ionutandrone01/VOLTAGE-AMPLIFIER/ANDRONE_Ionut_VOLTAGE AMPLIFIER/Layout/Layout.jpg

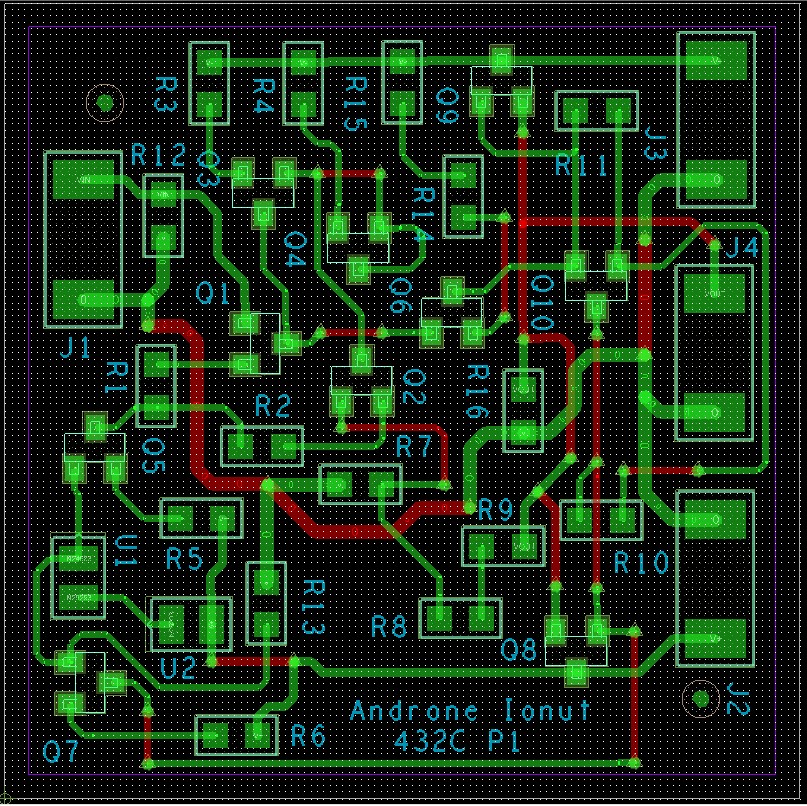
ANDRONE_Ionut_VOLTAGE AMPLIFIER/Layout/Layout.jpg
