ionutandrone01/VOLTAGE-AMPLIFIER/ANDRONE_Ionut_VOLTAGE AMPLIFIER/Project docs/ANDRONE_Ionut_AAF.pdf

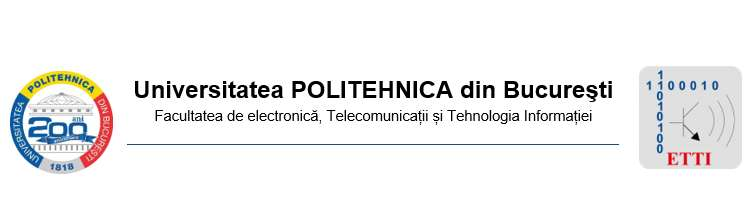
[picture p2: figure]

# PROIECT 1

# DISPOZITIVE SI CIRCUITE ELECTRONICE

# AMPLIFICATOR DE TENSIUNE

PROFESORI COORDONATORI: Ș. I. Dr. Ing. Miron Jean Cristea

Dr. Ing. Niculina Drăghici

## STUDENT: ANDRONE IONUȚ

## GRUPA 432C

## CUPRINS

1. Tema proiectului | pag. 3
2. Schema bloc | pag. 3
3. Schema electrica | pag. 4
4. Detalii de proiectare | pag. 4
4.1. Etajul diferential | pag. 6
4.2. Etajul emitor comun degenerat | pag. 6
4.3. Etajul de iesire in clasa AB | pag. 6
4.4. Sursa de curent | pag. 7
4.5. Oglinda de curent | pag. 7
5. Functionalitatea circuitului | pag. 8
6. Punctul static de functionare | pag. 9
7. Amplificarea in bucla inchisa | pag. 13
8. Amplificarea in bucla deschisa | pag. 14
9. Impedanta de intrare | pag. 15
10. Analiza domeniului temperaturilor de functionare | pag. 15
11. Bill of materials (BOM) | pag. 16
12.Bibliografie | pag. 16

1. TEMA PROIECTULUI (N=3):

Sa se proiecteze și realizeze un amplificator de tensiune avand urmatoarele caracteristici:

¨ Amplificarea de tensiune Av = 3 + N/2 = 3 + 1.5 = 4.5

¨ Tensiunea de intrare sinusoidala cu amplitudinea de 100mVv-v și f=1KHz;

¨ Impedanta de intrare 100kΩ;

¨ Rezistenta de sarcina 1Ω;

¨ Domeniul temperaturilor de functionare: 0

0C - 70⁰C (verificabil prin testare în temperatura);

¨ Amplificarea in tensiune minima (în buclă deschisa) a amplificatorului: minim 200;

¨ Semnalizarea prezenței tensiunilor de intrare/iesire cu dioda de tip LED.

### 2. SCHEMA BLOC A CIRCUITULUI

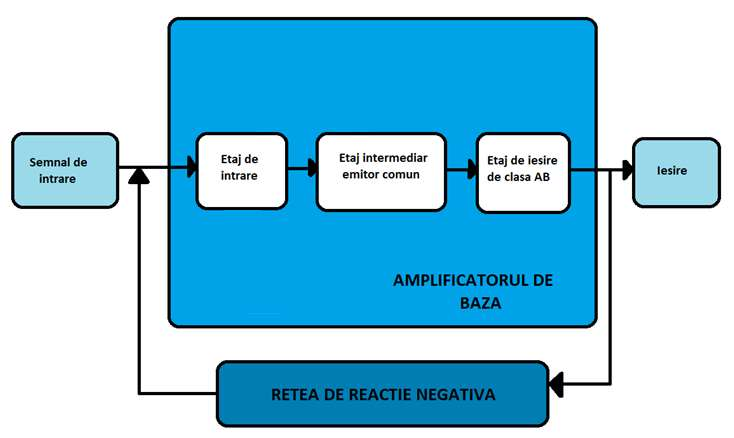
[picture p3: figure]

### 3. Schema electrica (in bucla inchisa)

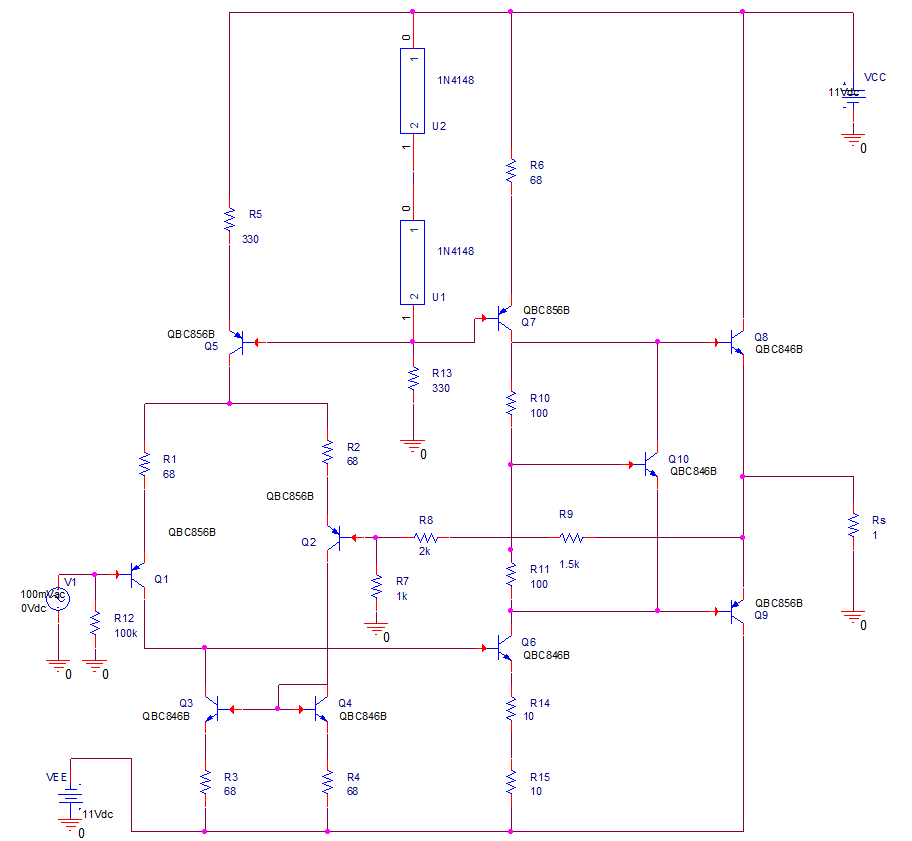
[picture p4: figure]

### 4. Detalii de proiectare

Circuitul este un amplificator de joasa frecventa cu reactie serie-paralel. Acesta este alcatuit din amplificatorul de baza si reteaua de reactie negativa. Amplificatorul de baza este la randul sau alcatuit din urmatoarele blocuri:
- Etajul de intrare: Etajul diferential
- Etajul intermediar: Etajul emitor comun degenerat
- Etajul de iesire: Etajul de clasa AB

Amplificatorul de baza prezinta totodata si alte 2 blocuri esentiale pentru functionarea circuitului:

- Sursa de curent
- Oglinda de curent

In figura urmatoare se evidentiaza fiecare bloc:

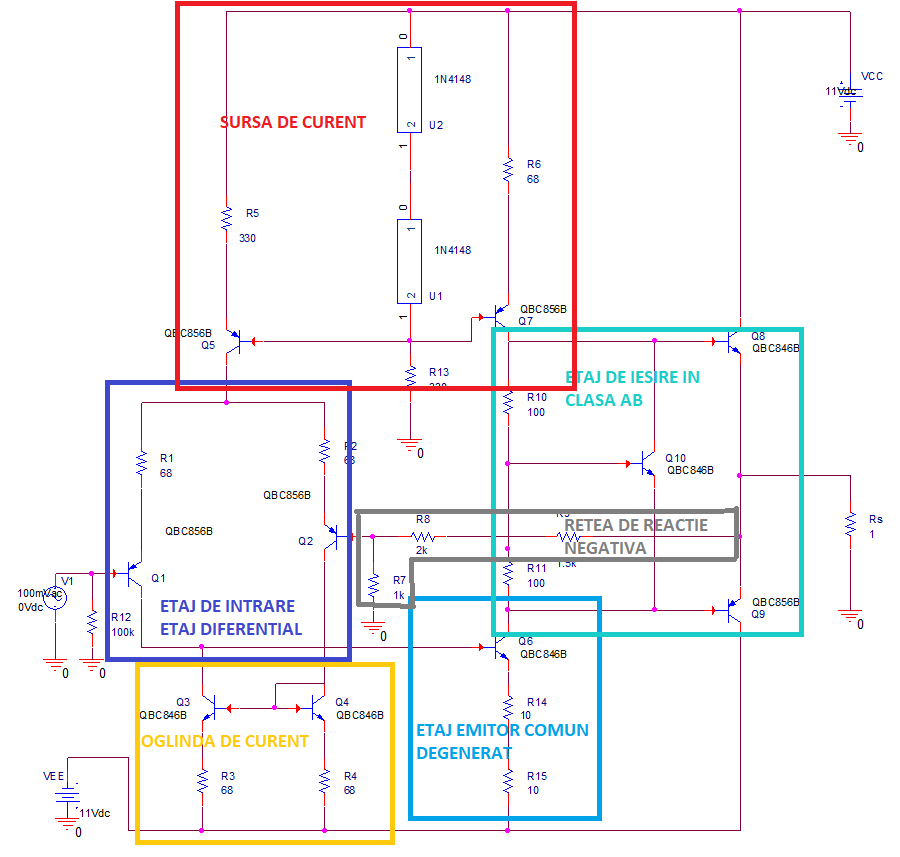
[picture p5: figure]

In continuare se va prezenta rolul fiecarui bloc in functionarea amplificatorului.

### 4.1. ETAJUL DIFERENTIAL

Etajul de intrare este realizat cu ajutorul unui amplificator diferential.

Amplificatorul diferential este un montaj electronic cu 2 intrari ce are rolul de a amplifica diferenta dintre semnalele aplicate la intrare.

In schema amplificatorului, etajul diferential este format din tranzistoarele PNP Q1 si Q2 de tipul BC856B si rezistentele de aceeasi valoare R1=R2 = 68Ω.

Acest etaj este essntial pentru functionarea cicuitului si totodata pentru a ajunge la amplificarea dorita.

Etajul face diferenta dintre tensiunea sinusoidala aplicata la intrare (in baza tranzistorului Q1) si semnalul adus in baza tranzistorului Q2 (prin intermediul reactiei negative). Acesta totodata realizeaza o amplificare ridicata in conditii de deriva minima si un raport semnal-zgomot favorabil.

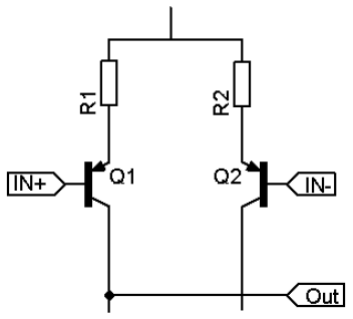
[picture p6: figure]

### 4.2. ETAJUL EMITOR COMUN DEGENERAT

Etajul emitor comun este etajul intermediar ce ajuta la o amplificare mai mare a semnalului. Acesta are rolul esential de adaptare spre blocul de iesire.

Etajul este un ‘’degenerat’’ deoarece are legate si rezistentele in serie R14 si R15 de emitorul tranzistorului Q6.

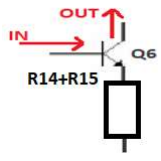
[picture p7: figure]

### 4.3. ETAJUL DE IESIRE IN CLASA AB

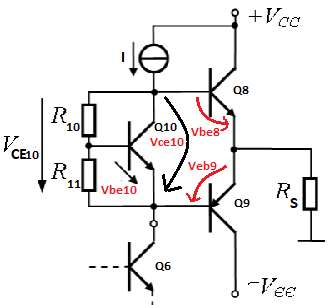
[picture p8: figure]

Etajul de iesire consta intr-un etaj de clasa AB, mai precis o configuratie folosita pentru evitarea ambalarii termice a acestuia.

Tranzistoarele Q8 si Q9 sunt polarizate prin multiplicarea tensiunii baza-emitor a tranzistorului NPN Q10 (Vbe10).

Din schema putem observa ca Vce10 = Vbe8 + Veb9 .Dar in acelasi timp se formeaza si un divizor de tensiune in baza tranzitorului Q10.

Asadar se poate scrie ca: Vbe10=Vce

R11
R11+R10

deci Vce10 = Vbe10(1 + R10
R11

).

Din acest motiv am ales rezistentele R10 = R11 egale in circuit, pentru a obtine Vce10=2Vbe10 . Astfel fortam tranzistoarele Q8 si Q9 sa lucreze in RAN, considerand ca tranzistoarele au tensiunile dintre baza-emitor aproximativ egale:

2Vbe10 = Vbe8+ Veb9.
Evitarea ambalarii termice a etajului de la iesire poate fi demonstrata astfel:
Consideram ca prin tranzistoarele Q8 si Q9 trece curentul IQ iar prin rezistenta de sarcina trece un curent neglijabil in raport cu IQ.
Stim ca Vce10 = Vbe8 + Veb9 | si ca | Vce10 = Vbe10(1 + R10 R11 ) deci putem sa scriem ca

Vth[ln(IQ
Is8

) + ln(IQ
Is9

)] =( 1 +

R10
R11

)Vthln(Ic10
| | Is10 ) asadar deducem ca:

IQ =√Is1Is2(
1
Is10

)

(1+

R10
R11)
. In concluzie curentul IQ nu va depinde de temperatura, ci doar de parametrii de model si rezistentele R10 si R11.

### 4.4. SURSA DE CURENT

| | Sursa de curent are rolul de a furniza un curent constant, fortand
| | impreuna cu oglinda de curent ca cele 2 tranzistoare din etajul
| | diferential (Q1 si Q2) sa absoarba curenti de aceeasi valoare.
| | Ic5= 2Vd−Veb5 R5 . In acest caz am notat Vd3 = Vd2 = Vd deoarece diodele
| | D1 si D2 sunt de acelasi tip.
| | Totodata, sursa de curent alimenteaza si etajul intermediar
| | emitor-comun cu ajutorul tranzistorului Q7.

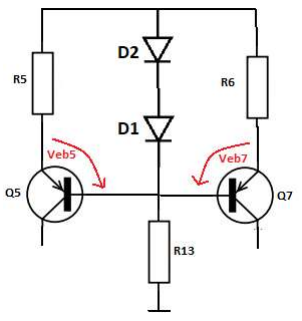
[picture p9: figure]

### 4.5. OGLINDA DE CURENT

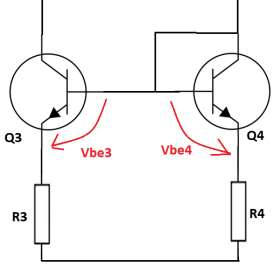
[picture p10: figure]

Oglinda de curent se defineste ca un repetor de curent cu schimbarea punctului de referinta al sarcinii.

In schema amplificatorului, oglinda de curent este formata din tranzistoarele Q3 si Q4, care sunt de acelasi tip. Asadar au aceeasi parametrii de model, inclusiv curentul de saturatie Is3=Is4. Daca tranzistoarele functioneaza la ceeasi temperatura: Vth3=Vth4.

Stiind in plus ca Vbe3=Vbe4 atunci rezulta ca Ic3=Ic4 deci Ic1=Ic2 , in conditiile in care curentii prin bazele tranzistoarelor sunt neglijabili.

Amplificatorul diferential impreuna cu oglinda de curent ofera performante mult mai bune.

### 5. FUNCTIONALITATEA CIRCUITULUI

Semnalul de intrare are o forma sinusoidala de amplitudine varf-la-varf de 100mV si o frecventa de 1kHz. Dupa cum se poate observa, impedanta de intrare este dictate de valoarea rezistentei R12. Pentru a indeplini cerinta temei si anume de a obtine o impedanta de intrare de 100 kΩ, am ales valoarea rezistentei 100kΩ. Explicatia este data de faptul ca impedanta de intrare este gruparea paralel dintre R12 si rezistenta de intrare in baza tranzistorului Q1. Cea din urma are o valoare de ordinul MΩ, astfel fiind anulata de valoarea lui R12.

Am ales valoarea tensiunilor de alimentare de 11V respectiv -11V pentru a putea obtine o amplificare in bucla deschisa mai mare de 200.

Alimentarea circuitului se realizeaza cu ajutorul sursei de curent Q5 ce determina pe etajul de intrare 2 curenti egali si constanti Ic1=Ic2=1.4 mA. Diodele D1 si D2 au rolul de a mentine tranzistoarele Q5, respectiv Q7 in RAN. Tranzistoarele Q3 si Q4 au rolul de a forma o oglinda de curent ce forteaza cei 2 curenti din etajul initial sa fie egali. Etajul diferential cu iesire asimetrica este urmat de etajul emitor comun degenerat, realizat cu ajutorul tranzistorului bipolar NPN Q6. Dioda D1 are rolul de a mentine Q3 in RAN astfel:

Conditia ca Q3 sa fie in RAN este ca Vce3 ≥ Vbe3.

Daca nu am pune o rezistenta, pe care are loc o cadere de tensiune nu am putea indeplini conditia ca tranzistorul Q3 sa fie in RAN:

Uce3 + UR3 = Vbe6 + UR14 + UR15 .

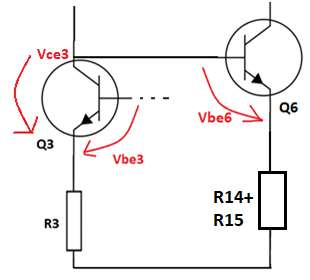
[picture p11: figure]

Curentul prin colectorul lui Q6 de 12.8 mA este asigurat tot prin intermediul sursei de curent, formata de data aceasta de tranzistorul PNP Q7.

Etajul intermediar este urmat de etajul de clasa AB, format din tranzistoarele Q8 si Q9. Tranzistorul Q10 nu are un rol in amplificarea circuitului, ci doar asigura impreuna cu rezistentele R10 si R11 faptul ca tranzistoarele bipolare Q8 si Q9 sunt polarizate prin multiplicarea tensiunii baza-emitor. Prin tranzistoarele ce formeaza etajul de iesire, sunt asigurati curentii Ic8 = 6.9 mA repectiv Ic9 = 6.9 mA.

Cele trei etaje de amplificare formeaza de fapt structura interna a unui amplificator operational.

Bucla de reactie negativa este formata de rezistentele R8, R9 si R7. Aceasta are intrarea la iesirea din amplificator si iesirea la intrarea in amplificator ( in baza lui Q2 ).

Amplificarea totala in bucla inchisa este data chiar de valoarea rezistentelor ce formeaza bucla de reactie:
A = 1 +

R9+R8
R7

### 6. PUNCTUL STATIC DE FUNCTIONARE

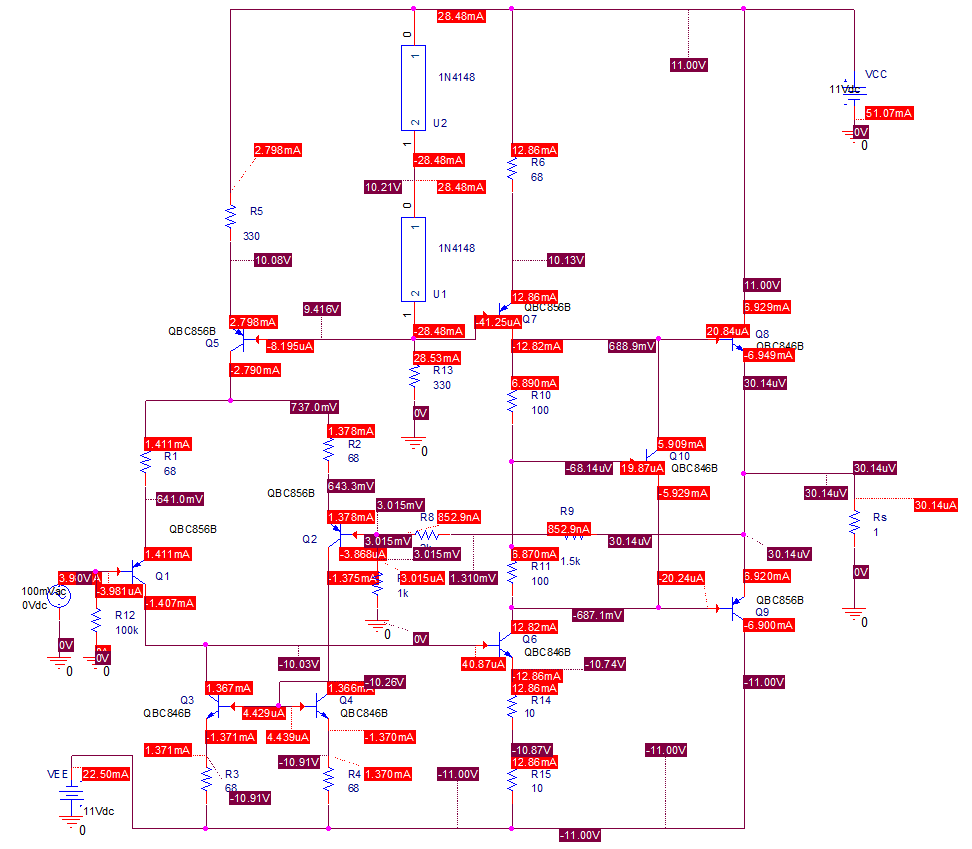
[picture p12: figure]

Q1: Vec1 = 10.6 V ≥ Veb1 => Q1 este in RAN Veb1 = 0.64V
Ic1 = 1.4 mA

Q2: Vec2 = 10.6 V ≥ Veb2 => Q2 este in RAN Veb2 = 0.61V
Ic2 = 1.37 mA

Q3: Vce3 = 0.88 V ≥ Vbe3 => Q3 este in RAN Vbe3 = 0.65V
Ic3 = 1.37 mA

Q4: Vce4 = 0.65 V ≥ Vbe4 => Q4 este in RAN Vbe4 = 0.65V
Ic4 = 1.36 mA

Q5: Vec5 = 9.3 V ≥ Veb5 => Q5 este in RAN Veb5 = 0.66V
Ic5 = 2.8 mA

Q6: Vce6 = 10 V ≥ Vbe6 => Q6 este in RAN Vbe6 = 0.71V
Ic6 = 12.8 mA

Q7: Vec7 = 9.4 V ≥ Veb7 => Q7 este in RAN Veb7 = 0.71V
Ic7 = 12.8 mA

Q8: Vce8 = 11 V ≥ Vbe8 => Q8 este in RAN Vbe8 = 0.68V
Ic8 = 6.9 mA

Q9: Vec9 = 11 V ≥ Veb9 => Q9 este in RAN Veb9 = 0.68V
Ic9 = 6.9 mA

Q10: Vce10 = 1.36V ≥ Vbe10 => Q10 este in RAN Vbe10 = 0.68V
Ic10 = 5.9 mA

Observam din simulare faptul ca curentii prin bazele tranzistoarelor sunt de ordinul uV asadar ii vom considera neglijabili.
Prin intermediul PSF-ului verificam si daca componentele circuitului se incadreaza in limitele caracteristice din foile de catalog.
De exemplu:
- Pentru DIODE:

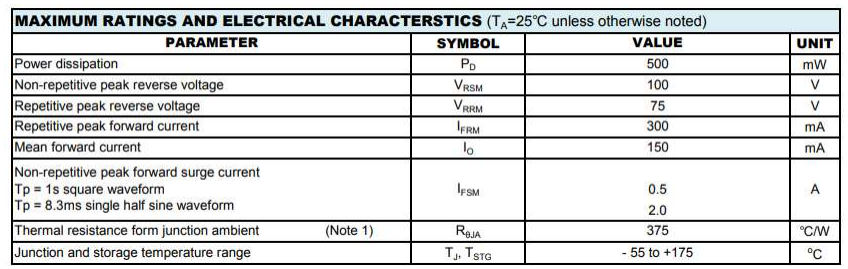
[picture p13: figure]
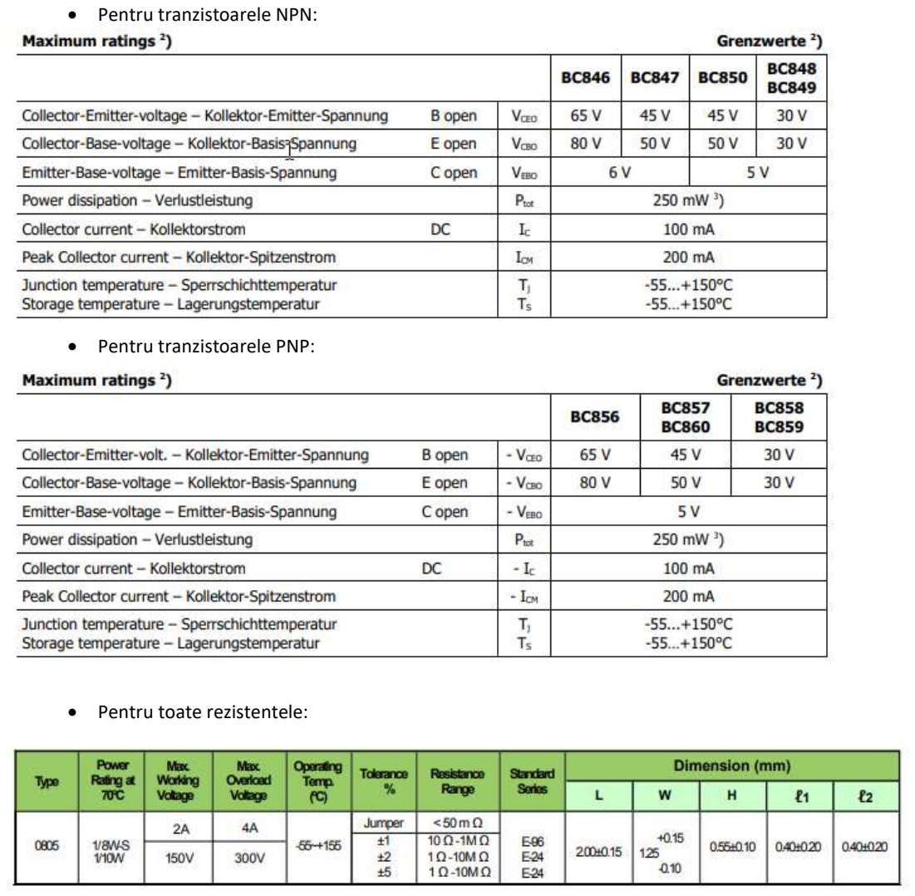
[picture p14: page 11]

- Pentru tranzistoarele NPN:
- Pentru tranzistoarele PNP:
- Pentru toate rezistentele:

Verificam si puterile electrice ale circuitului, si observam ca se incadreaza in limitele impuse de foile de catalog ale componentelor:

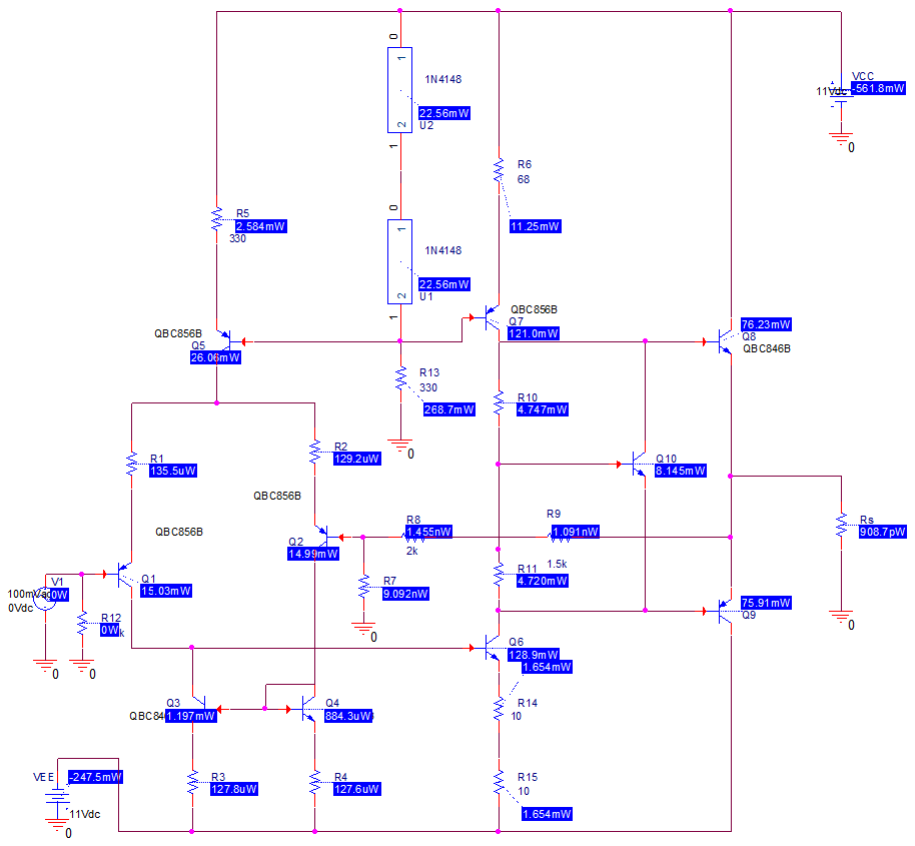
[picture p15: figure]

### 7. AMPLIFICAREA IN BUCLA INCHISA:

Amplificarea in bucla inchisa se poate calcula ca si A = 1 +

R9+R8
R7

= 1 + 1.5kΩ+2kΩ
1kΩ

= 1 + 3.5 = 4.5

Putem observa din simulare ca obtinem amplificarea de cat ne dorim si anume 4.47 , cu o eroare de 0.67% fata de ce am dorit sa obtinem.

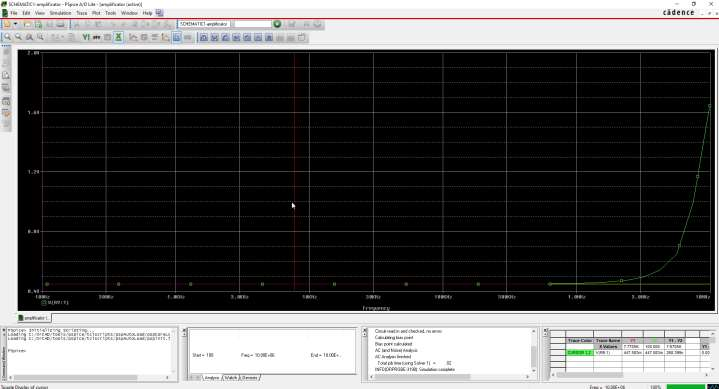
[picture p16: figure]
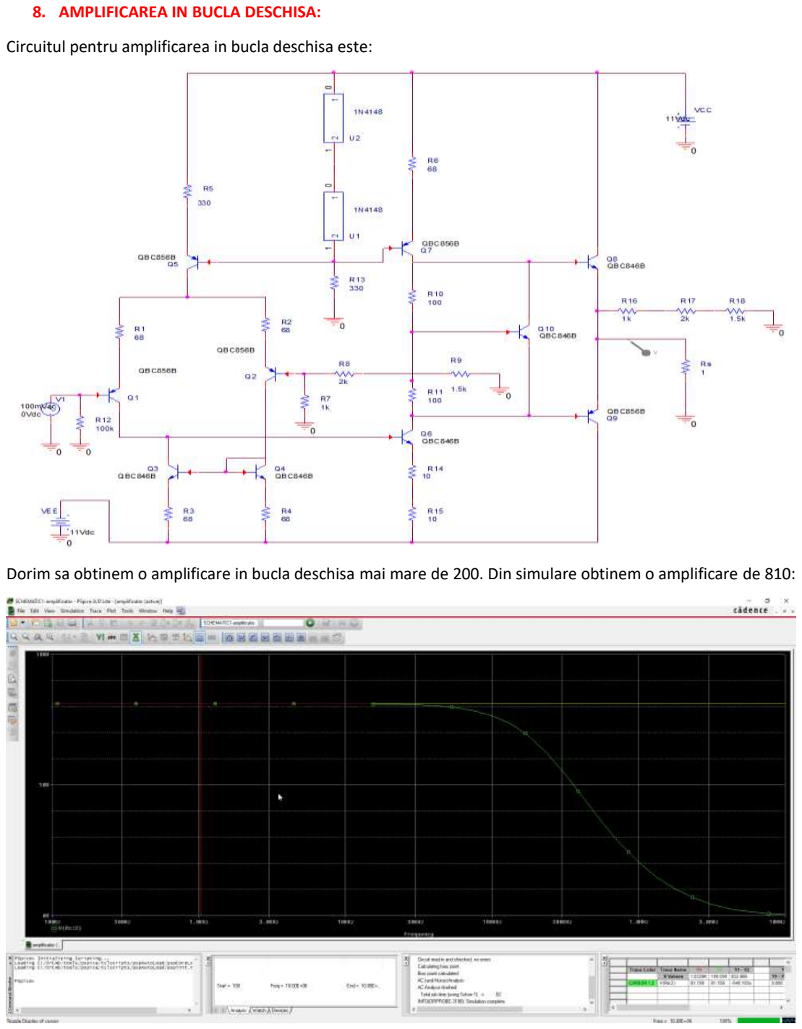
[picture p17: page 14]

### 8. AMPLIFICAREA IN BUCLA DESCHISA:

Circuitul pentru amplificarea in bucla deschisa este:

Dorim sa obtinem o amplificare in bucla deschisa mai mare de 200. Din simulare obtinem o amplificare de 810:

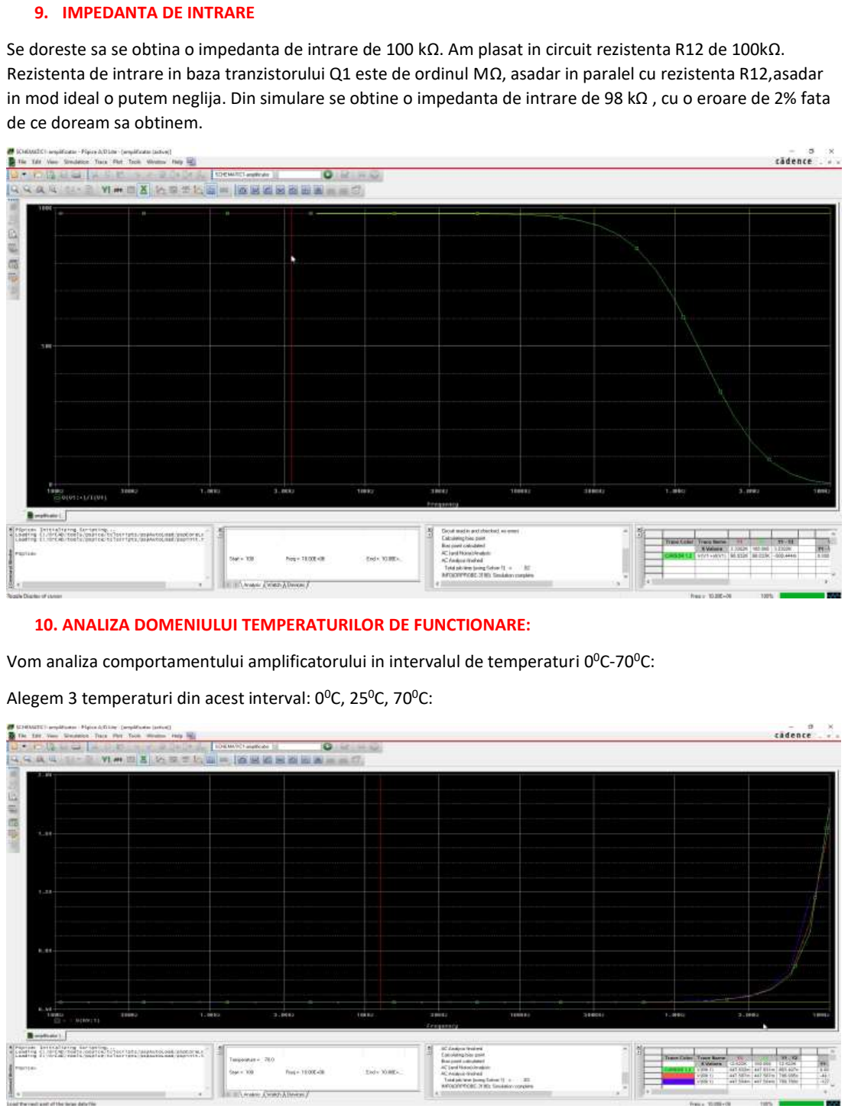
[picture p18: page 15]

### 9. IMPEDANTA DE INTRARE

Se doreste sa se obtina o impedanta de intrare de 100 kΩ. Am plasat in circuit rezistenta R12 de 100kΩ. Rezistenta de intrare in baza tranzistorului Q1 este de ordinul MΩ, asadar in paralel cu rezistenta R12,asadar in mod ideal o putem neglija. Din simulare se obtine o impedanta de intrare de 98 kΩ , cu o eroare de 2% fata de ce doream sa obtinem.

### 10. ANALIZA DOMENIULUI TEMPERATURILOR DE FUNCTIONARE:

Vom analiza comportamentului amplificatorului in intervalul de temperaturi 0

0C-70⁰C:

Alegem 3 temperaturi din acest interval: 0⁰C, 25⁰C, 70⁰C:

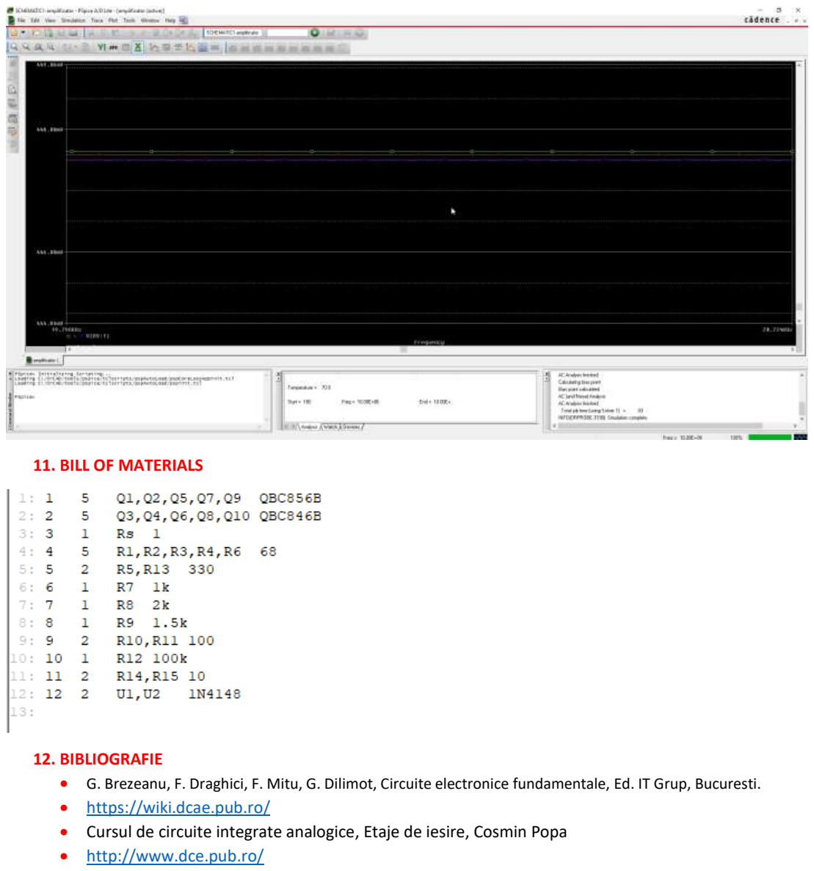
[picture p19: page 16]

### 11. BILL OF MATERIALS

### 12. BIBLIOGRAFIE

- G. Brezeanu, F. Draghici, F. Mitu, G. Dilimot, Circuite electronice fundamentale, Ed. IT Grup, Bucuresti.
- https://wiki.dcae.pub.ro/
- Cursul de circuite integrate analogice, Etaje de iesire, Cosmin Popa
- http://www.dce.pub.ro/
