ionutandrone01/VOLTAGE-AMPLIFIER/ANDRONE_Ionut_VOLTAGE AMPLIFIER/Schematics/schema_bloc.jpg

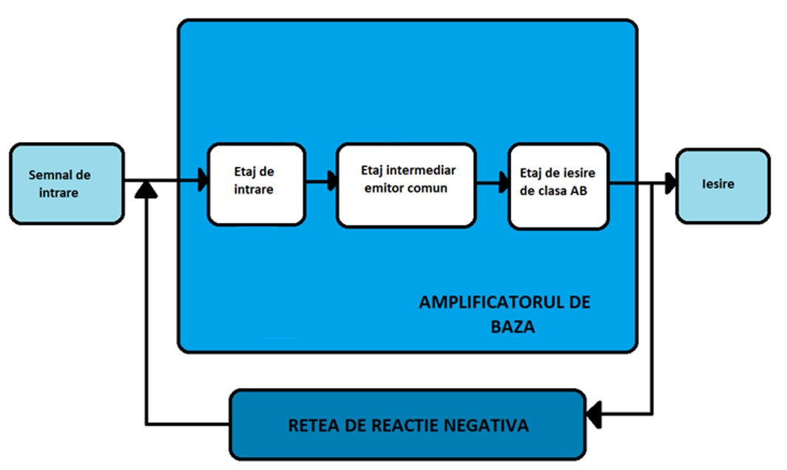
ANDRONE_Ionut_VOLTAGE AMPLIFIER/Schematics/schema_bloc.jpg
