ionutandrone01/VOLTAGE-AMPLIFIER/ANDRONE_Ionut_VOLTAGE AMPLIFIER/Schematics/schema_electrica.jpg

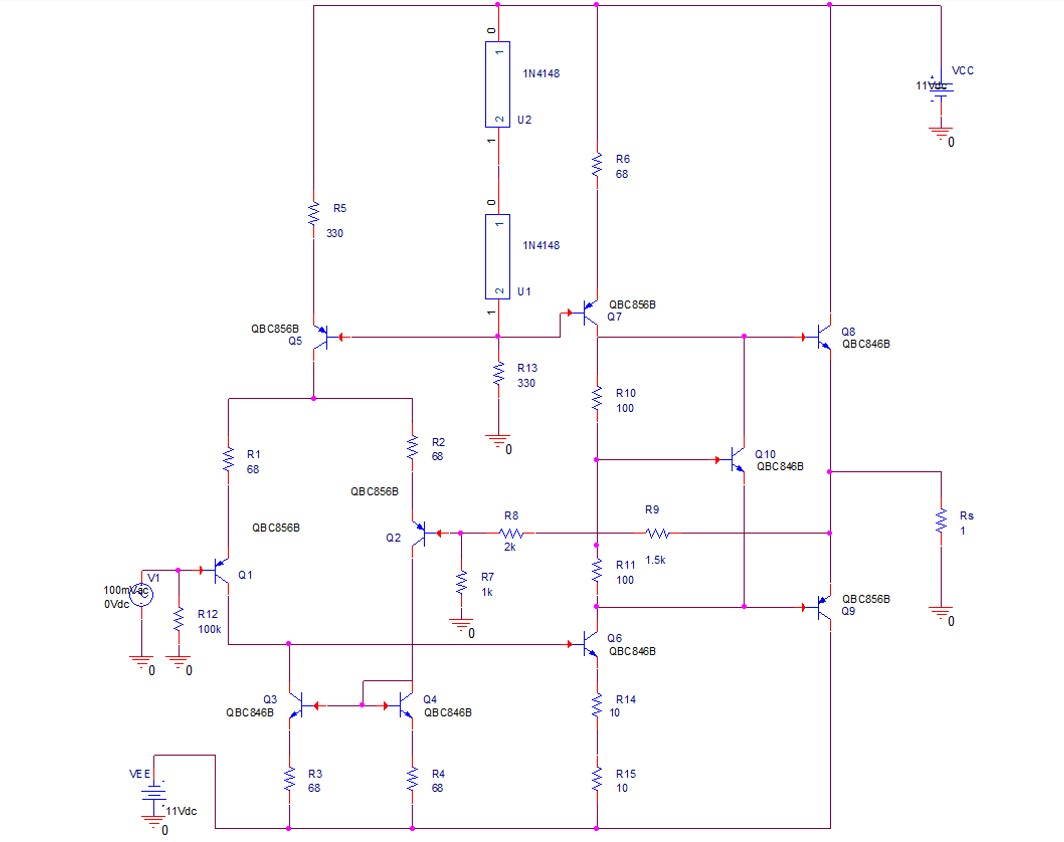
ANDRONE_Ionut_VOLTAGE AMPLIFIER/Schematics/schema_electrica.jpg
