ionutandrone01/VOLTAGE-AMPLIFIER/ANDRONE_Ionut_VOLTAGE AMPLIFIER/Simulations/Amplificarea_in_bucla_deschisa.jpg

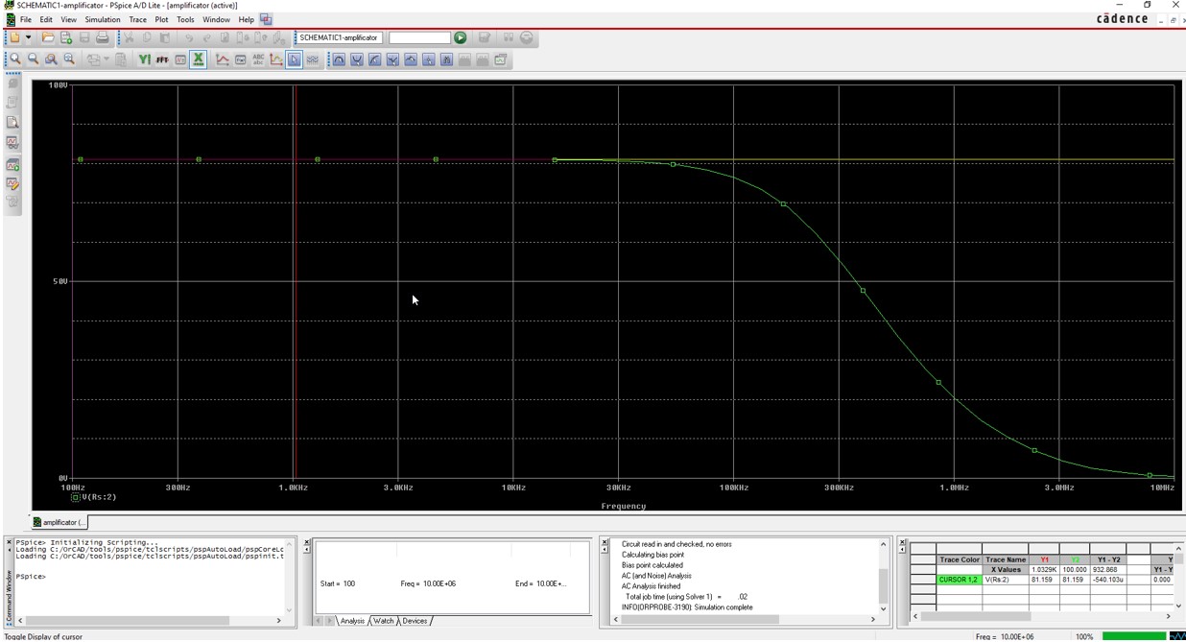
ANDRONE_Ionut_VOLTAGE AMPLIFIER/Simulations/Amplificarea_in_bucla_deschisa.jpg
