ionutandrone01/VOLTAGE-AMPLIFIER/ANDRONE_Ionut_VOLTAGE AMPLIFIER/Simulations/Analiza_domeniului_temperaturilor_de_functionare.jpg

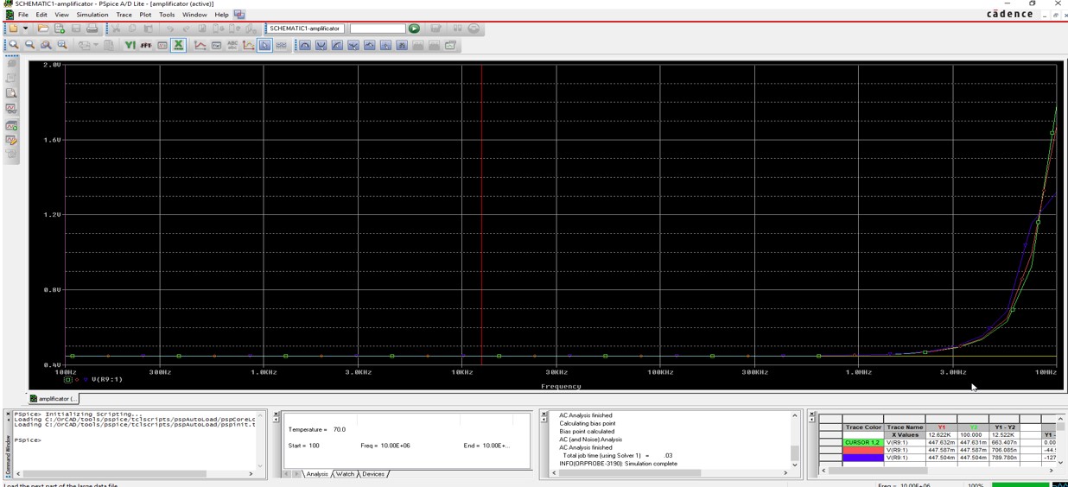
ANDRONE_Ionut_VOLTAGE AMPLIFIER/Simulations/Analiza_domeniului_temperaturilor_de_functionare.jpg
