ionutandrone01/VOLTAGE-AMPLIFIER/ANDRONE_Ionut_VOLTAGE AMPLIFIER/Simulations/Rezistenta_de_intrare.jpg

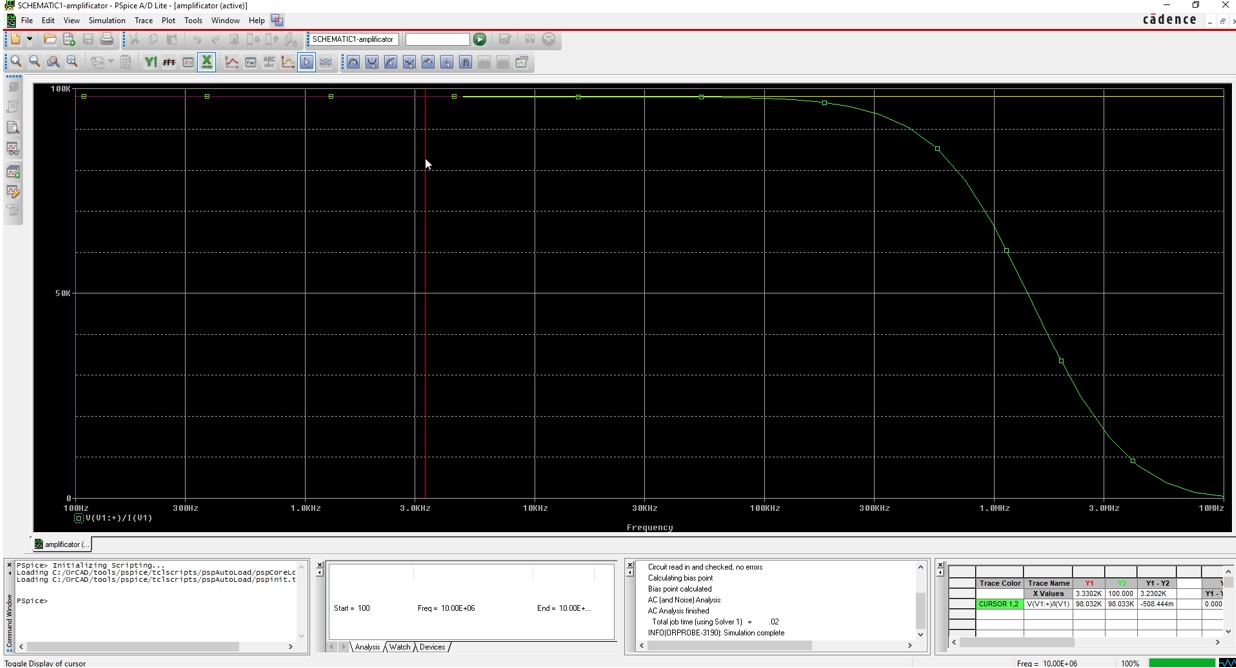
ANDRONE_Ionut_VOLTAGE AMPLIFIER/Simulations/Rezistenta_de_intrare.jpg
