ionutandrone01/VOLTAGE-AMPLIFIER/ANDRONE_Ionut_VOLTAGE AMPLIFIER/BOM P1DCE.pdf

CLASA | COD DISTRI BUITOR | Nume produs | TIP/ VALOARE | NOTATII IN SCHEMA | CANTITATE
Tranzistor PNP | BC856B | BC856B | QBC856B BIPOLAR PNP | Q1, Q2, Q5, Q7, Q9 | 5
Tranzistor NPN | BC846B | BC846B | QBC846B BIPOLAR NPN | Q3, Q4, Q6, Q8, Q10 | 5
Rezistor | SMD0805- 68R-1% | 0805S8F680 JT5E | 68 Ω | R1, R2, R3, R4, R6 | 5
Rezistor | SMD0805- 330R-1% | 0805S8F330 0T5E | 330 Ω | R5, R13 | 2
Rezistor | SMD0805- 1K-1% | 0805S8F100 1T5E | 1 kΩ | R7 | 1
Rezistor | SMD0805- 2K-1% | 0805S8F200 1T5E | 2 kΩ | R8 | 1
Rezistor | SMD0805- 1K5-1% | 0805S8F150 1T5E | 1.5 kΩ | R9 | 1
Rezistor | SMD0805- 100R-1% | 0805S8F100 0T5E | 100 Ω | R10, R11 | 2
Rezistor | SMD0805- 100K-1% | 0805S8F100 3T5E | 100 kΩ | R12 | 1
Rezistor | SMD0805- 10R-1% | 0805S8F100 JT5E | 10 Ω | R14, R15 | 2
Rezistor | SMD0805- 1R-1% | 0805S8F100 KT5E | 1 Ω | R16 | 1
Dioda pn | 1N4148- 0805 | CD4148WS( 0805C) | 4148 | U1, U2 | 2
CONN2 | ZL301-40P | ZL301-40P | Sir pini | J1, J2, J3, J4 | 4
