ionutandrone01/VOLTAGE-AMPLIFIER/(list of files, drawings)

Other design files:
ANDRONE_Ionut_VOLTAGE AMPLIFIER/Schematics/ANDRONE_Ionut_AAF.opj
